JKunnarter/control-motor-pcb-design/Altium Design/Preview_3D.png

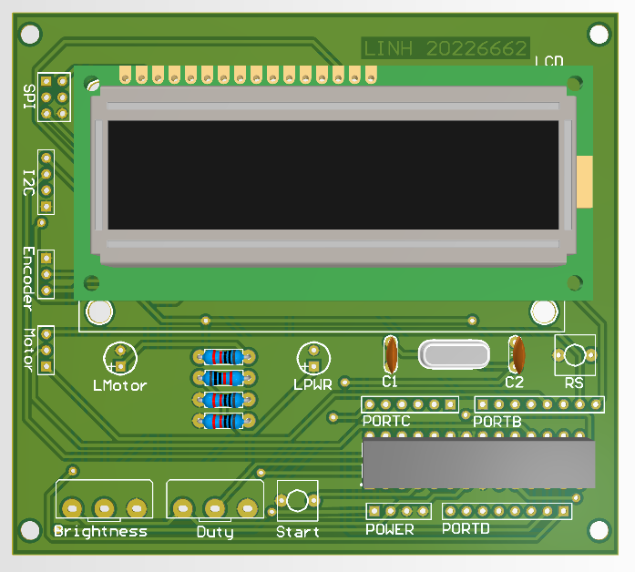
Altium Design/Preview_3D.png
