JKunnarter/control-motor-pcb-design/Proteus Design/Schematic_Proteus.PDF

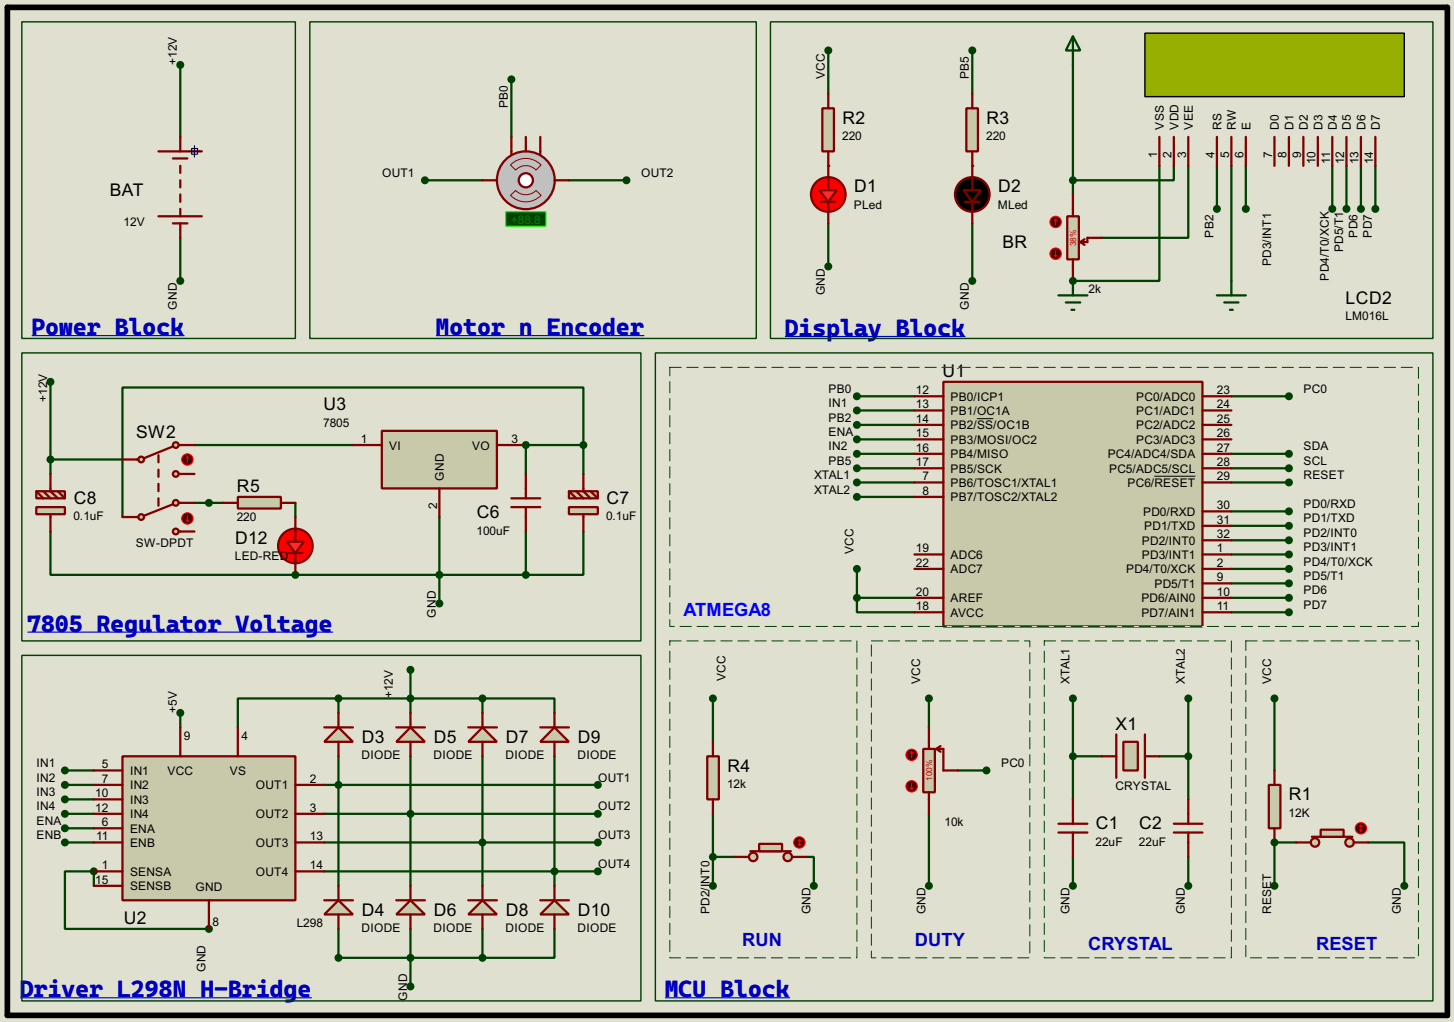
[picture p13: page 1]
