JKunnarter/control-motor-pcb-design/Altium Design/Schematic.pdf

# LPWR VCC

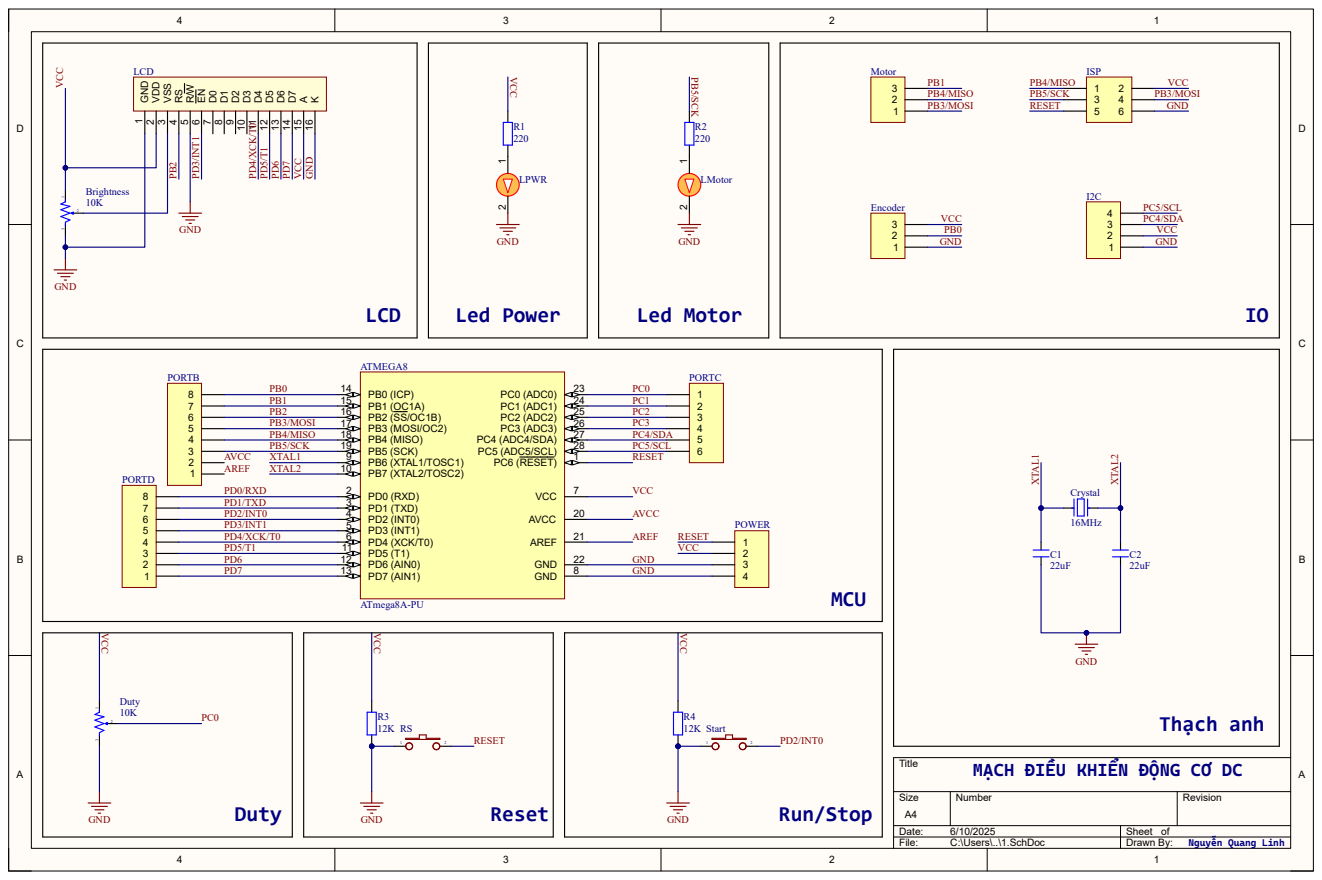
[picture p14: page 1]

MẠCH ĐIỀU KHIỂN ĐỘNG CƠ DC
