JKunnarter/control-motor-pcb-design/(list of files, drawings)

Other design files:
Altium Design/PCB_Design.PcbDoc
Altium Design/Project_Controller_Motor_DC.PrjPcb
Altium Design/Schematic.SchDoc
Proteus Design/Proteus_Final_Project.pdsprj
