JKunnarter/control-motor-pcb-design/(commit log)

2025-05-14 Create Schematic
2025-06-13 Update Project
    [1.SchDoc, PCB1.PcbDoc, Project_Controller_Motor_DC.PrjPcb, Proteus_Final_Project.pdsprj]
2025-06-13 Clean Project
    [PCB_Design.PcbDoc, Schematic.SchDoc]
2025-07-08 Add Proteus Schematic
    Add Proteus Schematic
